ra0sms/rp2040-cw-beacon/KiCad/beacon_rp2040/beacon_rp2040.pdf

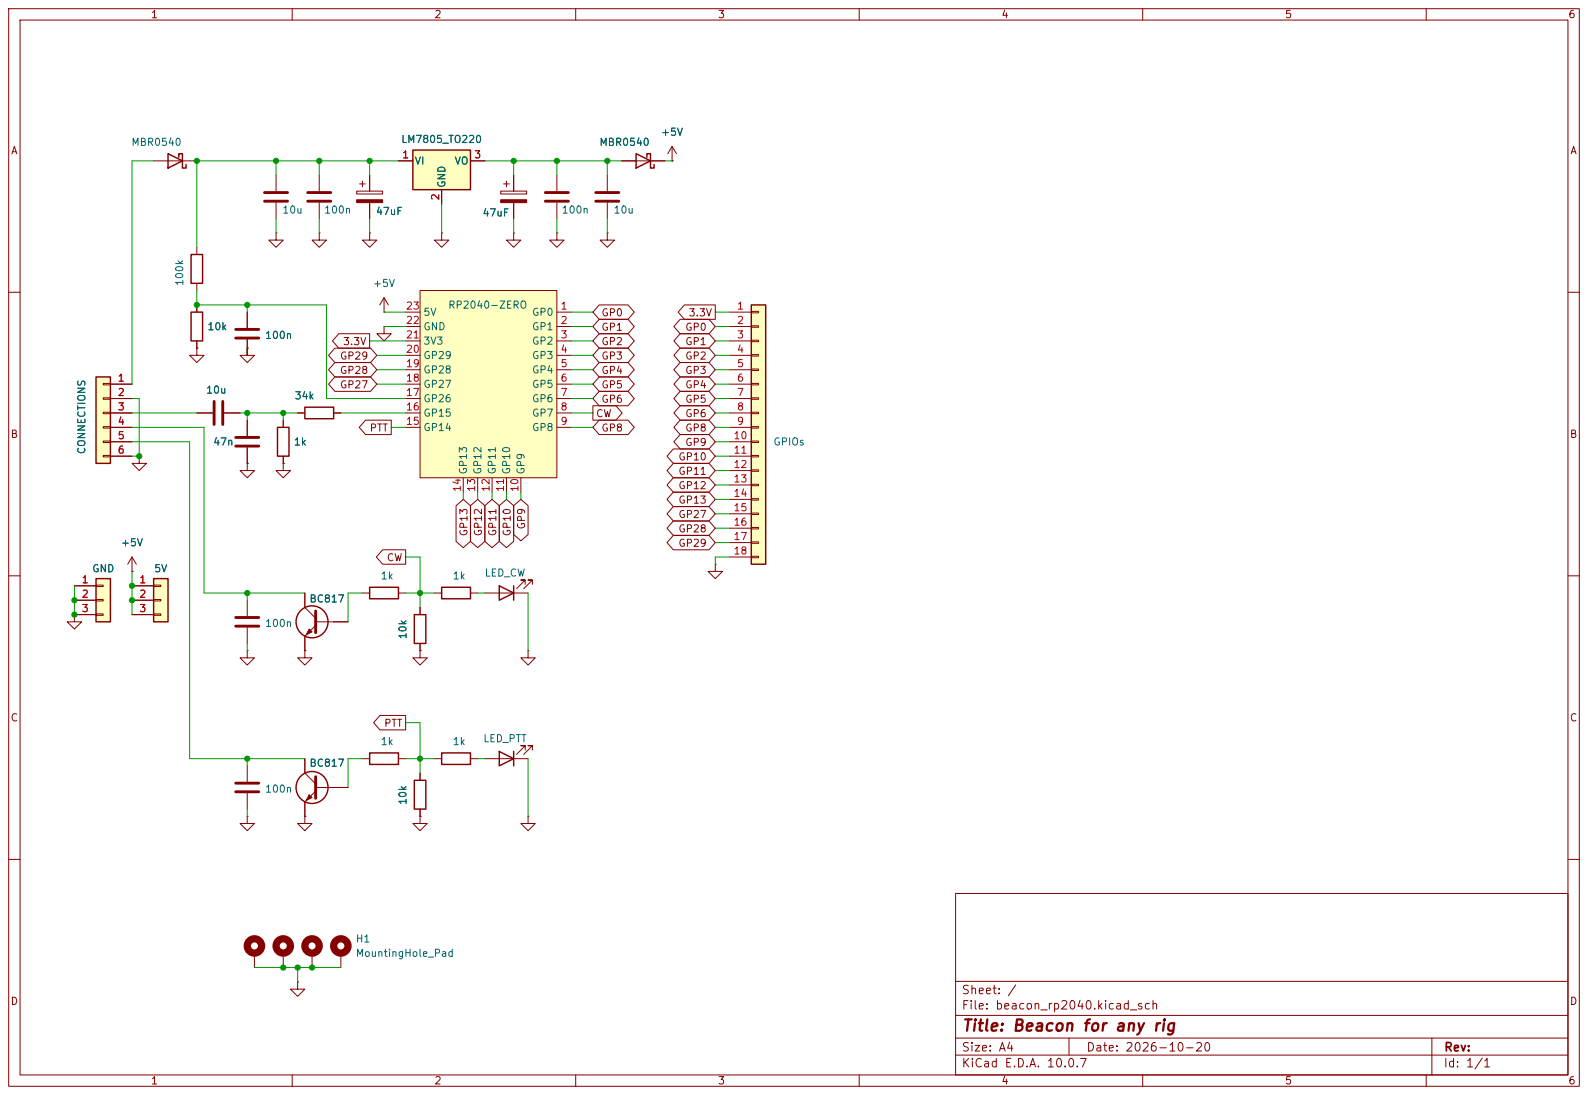
[picture p5: page 1]

4 4

Sheet: /
File: beacon_rp2040.kicad_sch
Title: Beacon for any rig

Size: A4 | Rev:
KiCad E.D.A. 10.0.7 | Id: 1/1
