ra0sms/rp2040-cw-beacon/KiCad/beacon_rp2040/beacon_rp2040.kicad_pcb

## KiCad design KiCad/beacon_rp2040/beacon_rp2040.kicad_pcb (2026-10-21)

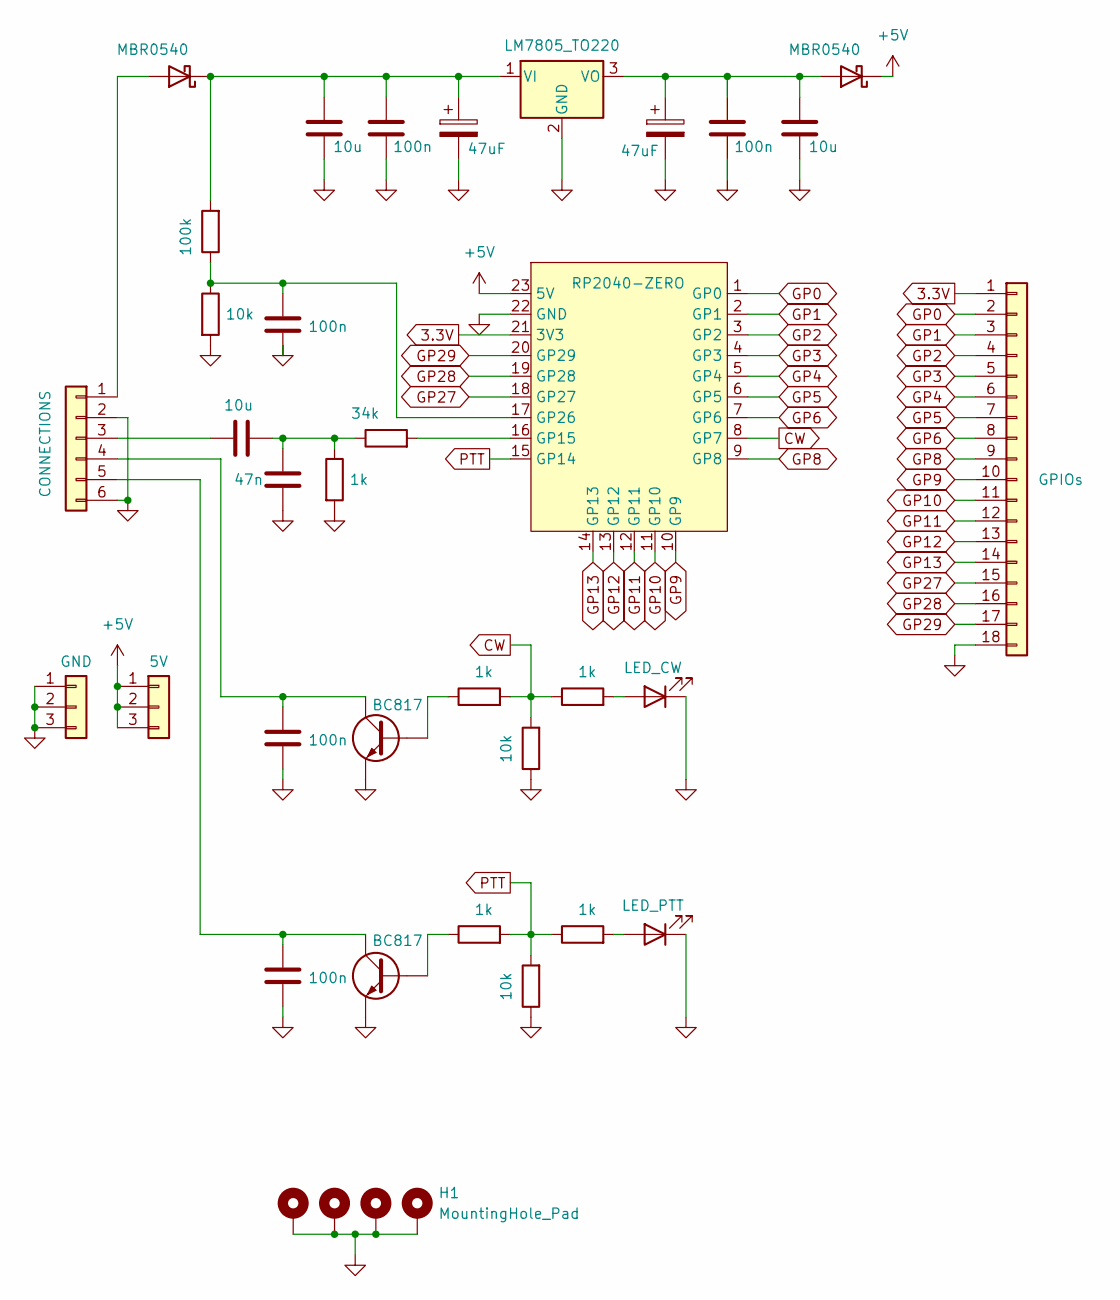
[picture p6: schematic beacon_rp2040.kicad_sch, Beacon for any rig]

Parts:
C2, C3, C5, C10, C11: 100n; C_1206_3216Metric
C4, C9, C12: 10u; C_1206_3216Metric
C6: 47n; C_1206_3216Metric
C13, C14: 47uF; CP_Radial_D5.0mm_P2.50mm
D1, D4: MBR0540; D_SOD-123
D2: LED_CW; PinHeader_1x02_P2.54mm_Vertical
D3: LED_PTT; PinHeader_1x02_P2.54mm_Vertical
H1, H2, H3, H4: MountingHole_Pad; MountingHole_3.2mm_M3_DIN965_Pad
J1: CONNECTIONS; PinHeader_1x06_P2.54mm_Vertical
J2: GPIOs; PinHeader_1x18_P2.54mm_Vertical
J3: GND; PinHeader_1x03_P2.54mm_Vertical
J4: 5V; PinHeader_1x03_P2.54mm_Vertical
Q3, Q4: BC817; SOT-23-3
R1: 34k; R_1206_3216Metric
R2, R4, R6, R9, R10: 1k; R_1206_3216Metric
R3, R5, R8: 10k; R_1206_3216Metric
R7: 100k; R_1206_3216Metric
U1: RP2040-ZERO; COMM-SMD_RP2040-ZERO; MPN RP2040-Zero; LCSC Part C5350143
U2: LM7805_TO220; TO-220-3_Vertical

Connections:
3.3V: J2.1, U1.21 (3V3)
+5V: D1.1 (K), J4.1, J4.2, J4.3, U1.23 (5V)
CW: R3.2, R4.1, R9.2, U1.8 (GP7)
GND: C2.1, C3.1, C5.1, C6.1, C9.2, C10.2, C11.2, C12.2, C13.2, C14.2, D2.1 (K), D3.1 (K), H1.1 (1_1), H2.1 (1_1), H3.1 (1_1), H4.1 (1_1), J1.2, J1.6, J2.18, J3.1, J3.2, J3.3, Q3.2 (E), Q4.2 (E), R2.2, R3.1, R5.1, R8.2, U1.22 (GND), U2.2 (GND)
GP0: J2.2, U1.1 (GP0)
GP1: J2.3, U1.2 (GP1)
GP2: J2.4, U1.3 (GP2)
GP3: J2.5, U1.4 (GP3)
GP4: J2.6, U1.5 (GP4)
GP5: J2.7, U1.6 (GP5)
GP6: J2.8, U1.7 (GP6)
GP8: J2.9, U1.9 (GP8)
GP9: J2.10, U1.10 (GP9)
GP10: J2.11, U1.11 (GP10)
GP11: J2.12, U1.12 (GP11)
GP12: J2.13, U1.13 (GP12)
GP13: J2.14, U1.14 (GP13)
GP27: J2.15, U1.18 (GP27)
GP28: J2.16, U1.19 (GP28)
GP29: J2.17, U1.20 (GP29)
unnamed: C4.1, C6.2, R1.1, R2.1
unnamed: C11.1, C12.1, C13.1, D1.2 (A), U2.3 (VO)
unnamed: D2.2 (A), R4.2
unnamed: D3.2 (A), R6.2
unnamed: D4.2 (A), J1.1
unnamed: C9.1, C10.1, C14.1, D4.1 (K), R7.2, U2.1 (VI)
unnamed: C4.2, J1.3
unnamed: C2.2, J1.4, Q4.3 (C)
unnamed: C3.2, J1.5, Q3.3 (C)
unnamed: Q3.1 (B), R10.1
unnamed: Q4.1 (B), R9.1
unnamed: R1.2, U1.16 (GP15)
unnamed: C5.2, R7.1, R8.1, U1.17 (GP26)
PTT: R5.2, R6.1, R10.2, U1.15 (GP14)

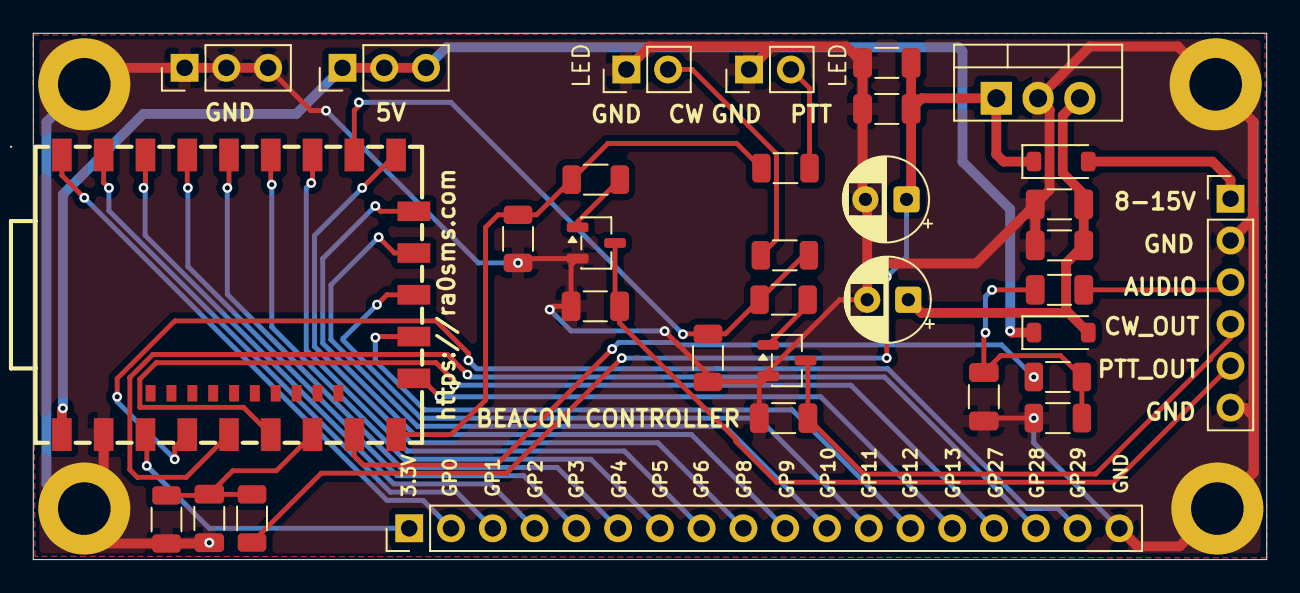
[picture p7: board beacon_rp2040.kicad_pcb from above]

Board: 2 copper layers, 75.0 x 32.0 mm, 37 parts (0 on the bottom side), 34 nets.
