ra0sms/rp2040-cw-beacon/(commit log)

2026-10-09 Initial commit: RP2040-Zero CW/tone beacon
    - Beacon.c: Morse/tone beacon firmware for Waveshare RP2040-Zero (Pico SDK 2.3.1):
    PWM tone output (GP15), PTT (GP14), CW key output (GP13), WS2812 status LED,
    tone sequences, USB console configuration, flash-stored config
    - gui/beacon_gui.py: PyQt5/PyQt6 configuration GUI over USB serial
    - README.md, requirements.txt, .gitignore, pics (pinout, GUI screenshot)
2026-10-09 Add prebuilt firmware binary and build instructions
    - firmware/Beacon-v0.1.uf2: ready-to-flash binary, tracked in git
    (.gitignore updated to keep firmware/*.uf2)
    - README: new 'Flashing' section using the prebuilt binary; expanded
    'Building from source' with toolchain install steps (Fedora/Debian,
    Pico SDK 2.3.1, VS Code extension alternative)
2026-10-10 Add Windows GUI build, KiCad schematic/PCB sources
    - gui/beacon_gui.exe: standalone Windows build of the GUI (PyInstaller),
    linked in README
    - KiCad/beacon_rp2040: schematic, PCB, symbol libs for the beacon board
    - .gitignore: exclude KiCad backups/lockfiles (*.lck, *-backups/, *.bak,
    *.kicad_prl)
    [beacon_rp2040.kicad_pcb, beacon_rp2040.kicad_sch]
2026-10-10 Status LED: red keyed blink during TX, steady green in pause
    - WS2812 follows the keying: red while the tone/key sounds, dark in the gaps
    - steady green between transmissions (pause and idle)
    - removed the old 500 ms blink timer
    - firmware/Beacon-v0.1.uf2 rebuilt
    [beacon_rp2040.kicad_sch]
2026-10-14 Hardcode active-high PTT and CW key levels
    - firmware: removed ptt_active_level config field and 'ptt' command;
    ptt_set()/key_set() now always drive logic 1 when active (magic bumped)
    - show/help/default updated accordingly
    - GUI: removed PTT active level selector
    - README: PTT/key documented as fixed active-high
    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
    [Beacon.c, beacon_gui.py]
2026-10-14 GUI: fix tones never sent unless tones/both mode selected
    - the 'tones' command was only sent when the TX mode combo was 'tones'/'both';
    with mode 'cw' the filled-in sequence was silently dropped
    - tones are now sent whenever the field is non-empty
    - 'Save to flash' now applies the fields first, then stores them
    - warning shown if tones/both mode is selected with an empty sequence
    [beacon_gui.py]
2026-10-16 Sine tone, timer-driven keying, stricter config and GUI command queue
    Firmware (v0.2):
    - Sine tone via DDS on a 62.5 kHz PWM carrier with 5 ms raised-cosine
    rise/fall (no key clicks)
    - Whole transmission laid out in advance and played by a hardware timer
    alarm: console and USB output no longer affect keying timing;
    'save' during a transmission is deferred until it ends
    - Watchdog, 120 s time-out timer, immediate abort on 'txen 0',
    outputs initialised before the start-up delay
    - Strict input parsing (strtol, tone entries), errors on too long
    or non-ASCII lines instead of silent truncation
    - More Morse characters and <prosigns>, message validated on input
    - Config stored with version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
    [Beacon.c, beacon_gui.py]
2026-10-21 Controller board: schematic, PCB, Gerbers, BOM; README hardware docs
    - KiCad schematic and routed 2-layer PCB (75 x 32 mm): LM7805 supply
    with reverse-polarity and USB isolation diodes, audio attenuator with
    low-pass filter, BC817 open-collector PTT/CW outputs, Vin divider on
    GP26, GPIO/5V/GND expansion headers, M3 mounting holes
    - Schematic PDF, Gerber + drill files (also zipped), interactive BOM
    - Schematic and 3D view images in pics/
    - README: board description, J1 pinout, outputs, power, expansion
    headers, manufacturing files and BOM; GUI download is now the zip
    - VS Code CMake Tools builds into code/Beacon/build like the scripts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
    [beacon_rp2040-B_Cu.gbr, beacon_rp2040-B_Mask.gbr, beacon_rp2040-B_Paste.gbr, beacon_rp2040-B_Silkscreen.gbr, beacon_rp2040-Edge_Cuts.gbr, beacon_rp2040-F_Cu.gbr, beacon_rp2040-F_Mask.gbr, beacon_rp2040-F_Paste.gbr]
